Huzaifa-Rahim-Malik/Industrial-Fault-Simulator/docs/Sensor_Description.docx

S/N | Sensor Name | Signal Type | Number | Location of Sensors on System | Input Voltage @ Amp | Output Signal Range | Connector and Cable Requirement | DAQ | Remarks
1. | Accelerometer | Analog | 9 | 1. Gear. 2. Induction Motor. 3. Bearing x5. 4. On Table x2. | 18-30VDC @ 0.5mA to 8mA | 100mv/g | M12 Euro fast Connector Cable | Required
2. | Acoustic | | 7 | 1. Induction Motor. 2. Gear. 3. Bearing x5. | | | | Required
3. | Temperature sensor | Analog | 4 | 1. Induction Motor. 2. Gear. 3. Small Tank. 4. Large Tank. | 4 to 30V DC @1.5mA | 0 to 5 VDC | 3 pin Connector | Required
4. | Voltage Sensor | Analog | 2 | 1. Induction Motor. 2. Power Supply. | 24VDC @4-20mA | 0 to 1000V AC | Not Required | Required
5. | Current Sensor | Analog | 2 | 1. Induction Motor. 2. Power Supply. | 0 to 30A AC | 0 to 1V AC | 2 pin Terminal Block to female RCA Connector | Required
6. | Tachometer | Digital | 2 | 1. Before Gear. 2. After Gear. | 100-240V AC @ 10VA max | 30V DC @ 100mA | Not Required | Required
7. | Water Level Sensor (Float Switch Sensor) | Digital | 2 | 1. Small Tank. 4. Large Tank. | 220V DC@1.5A | 0 to 5V Digital Signal | Not Required | Required
8. | Flow Sensor | Digital | 2 | 1. Small Tank. 2. Large Tank. | 5V to 15V DC @ 15mA | 0 to 5V Digital Signal | 3 pin Male Connector | Required
9. | Humidity Sensor | Digital | 2 | 1. Small Tank. 2. Large Tank | 3.3V to 6V DC @ 1 to 1.5mA | 0 to 5V Digital Signal | 4 pin Connector

Industrial Test Rig Simulator Sensor Description
