Huzaifa-Rahim-Malik/Industrial-Fault-Simulator/docs/Labview_Implementation.pdf

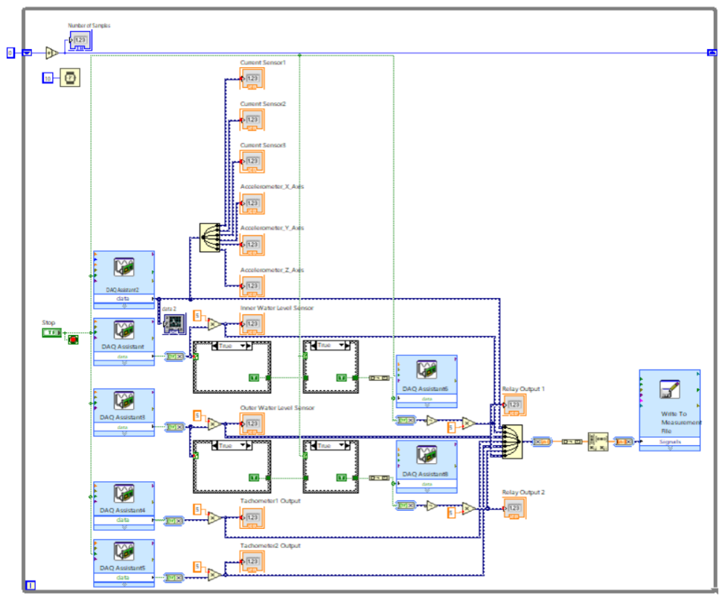
[picture p8: figure]
