Huzaifa-Rahim-Malik/Industrial-Fault-Simulator/Old_Design/docs/Hardware_Description.pdf

# DETAILED DESCRIPTION OF INDUSTRIAL TEST RIG

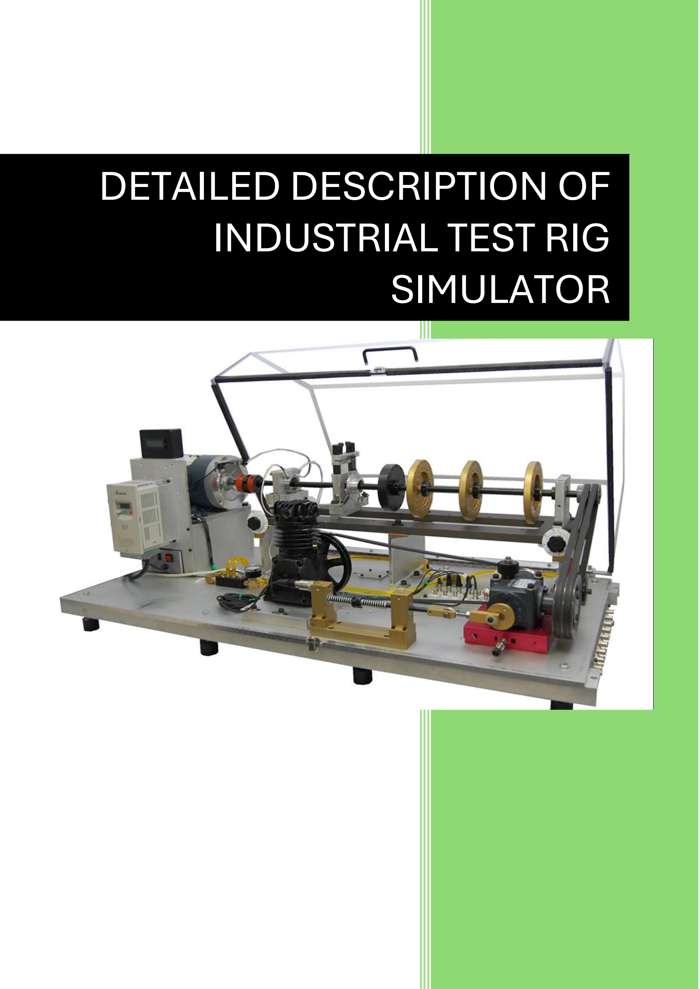
[picture p9: page 1]

# SIMULATOR

# Table of Contents

1. Introduction | 1
1.1) Overview | 1
1.2) Types of Sensors | 1
1.3) Other Technical Hardware used in System | 3
2. System Block Diagram | 5
3. Hardware Connection | 7
4. Software | 11
4.1) LabView Code | 11
5. Conclusion | 14

# List of Figures

Figure 1: Horizontal Water Level Sensor | 1
Figure 2: Vertical Water Level Sensor | 1
Figure 3: SCT-030 Current Sensor | 2
Figure 4: Temperature and Humidity Sensor | 2
Figure 5: Tachometer with Incremental Encoder | 2
Figure 6: Triaxial Accelerometer | 2
Figure 7: ATX Power Supply | 3
Figure 8: Induction Motor | 3
Figure 9: NI USB-6008 DAQ Device | 3
Figure 10:KTC Tension Controller with Powder Brake and Electromagnetic Clutch | 4
Figure 11: 2-Channel Relay Module with Magnetic Drive PumpError! | Bookmark | not
defined.
Figure 12:Industrial Test Rig Block Diagram | 6
Figure 13: Tachometer Pinout | 8
Figure 14: 2-Channel Relay Setup | 8
Figure 15: Industrial Test Rig Simulator Hardware Connection Schematic Diagram | 10
Figure 16: LabView Code | 12
Figure 17: Write to Measurement File VI | 13
Figure 18: LabView Front Panel | 14
Figure 19: Data Logged in text file | 14

# List of Tables

Table 1: Power Supplies Used in System | 3
Table 2: 3-Phase Motor Specification | 3
Table 3: Magnetic Pump Specification | 4
Table 4: Power Supplies Used by Devices | 7
Table 5: DAQ Device Connections | 11

## 1.Introduction

1.1) Overview
An industrial test rig simulator is basically a system that is designed to essentially replicate the functionality of real industrial machinery or equipment, thereby allowing actual situations to be tested, troubleshoot, and experimented without risking or costing real-world machinery. With the helps of sensors, we will be able to acquire the actual situation of the system/ equipment’s used in plants. This document includes the description about sensor used in this setup, their functionality in the system, operational information and hardware circuit implementation.
1.2) Types of Sensors
Different types of analog and Digital Sensors have been used in this industrial test rig simulator. The sensors that are used in this setup is given below:
- 1x Horizontal Water Level Sensor.
- 1x Vertical Water Level Sensor.
- 3x AC Current Sensor.
- 1x Temperature and Humidity Sensor.
- 2x Tachometers with Incremental Encoder.
- 3x 3-Dimensional Accelerometers.

The analog sensors such as AC current sensors and accelerometers gives an analogue output while the digital sensors such as horizontal water level, vertical level sensor, tachometer gives us digital output.

i. Horizontal Water Level Sensor
The horizontal water level sensor is used to identify water level in the system. They are installed at such systems where vertical space is not favourable. It is the passive sensor which only have two signals that is signal and ground. The sensor is installed in a water tank to measure water level of the tank and take necessary action according to the situations. The sensor is shown in figure 1.
ii. Vertical Water Level Sensor

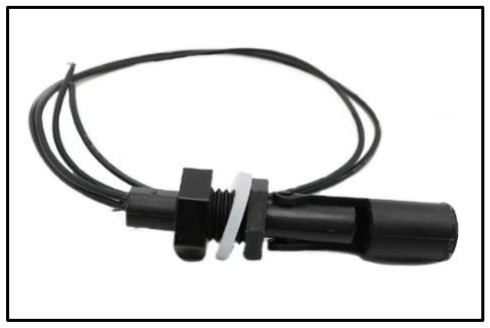
[picture p10: figure]

The vertical water level sensor is like horizontal water sensor as discussed above that is used to identify vertical water level in the system. It is the passive sensor which only have two signals that is signal and ground. The sensor is shown in figure 2.

Figure 1: Horizontal Water Level Sensor

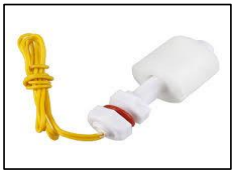
[picture p11: figure]

Figure 2: Vertical Water Level Sensor

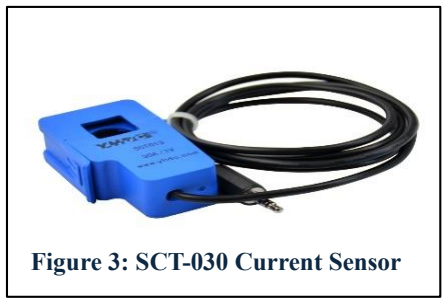
[picture p12: figure]
Figure 3: SCT-030 Current Sensor

iii. AC Current Sensor
The SCT-013-030 is a non-invasive AC Current Sensor Clamp Sensor 30A i.e. it is a current transformer that can be used to measure AC current up to 30 amperes. This SCT-013-030 Non-invasive AC Current Sensor 30A clamped around the supply line can measure a load up to 30 Amps and allow you to calculate how much current pass through it.

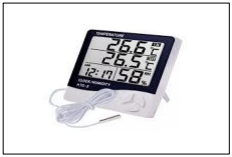
[picture p13: figure]

iv. Temperature and Humidity Sensor
Digital Thermometer and Hygrometer HTC-2 are 3 in 1 meter. This HTC 2 humidity meter allows you to display time clock, temperature, humidity and alarm function with a single cell. This digital meter has temperature range: -50 ~ 70 degrees (-58 ~ 158 ° F), large character LCD display, easy to read, lower power consumption This temperature and humidity meter can show temperature, humidity and time display simultaneously as shown in figure 4.
v. Tachometers with Incremental Encoder
CTA-4001A is a 3 in 1 device having timer / counter/ tachometer function with mixed timer and counter function. The 6-digit LCD display allow you to read this function with more accuracy and precisely. Different input like NPN/ PNP allow you to measure the function with different devices/sensors. The tachometer is
shown in figure 5. In this application of industrial test
rig, we use this device in tachometer with incremental
encoder (E6B2-CWZC) to measure the number of rotation (rpm) of 3-phase induction motor. The 2000 pulses per revolution substantially improve measuring accuracy. The encoder is NPN has an open collector output as shown in figure 5.

vi. Accelerometers

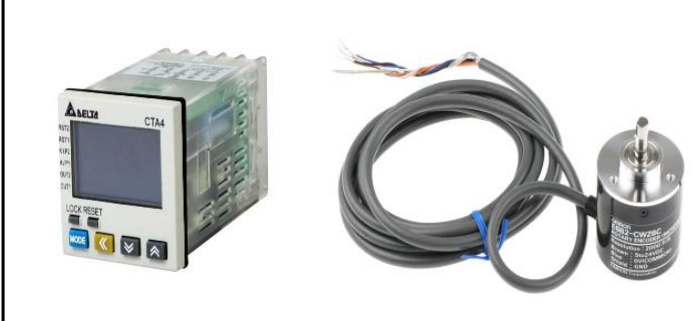
[picture p14: figure]

The CMCP760TT Side Exit Triaxial Accelerometer with Temperature output is the ideal accelerometer for most types of rotating equipment. The triaxial accelerometer allows us to measure each axis separately with a sensible accuracy of 100 mV/g. The CMCP760TT is waterproof and can be hosed down when using the proper extension cable. The sensor sensitivity 100 mV/g precisely measure the amount of vibration generates on the system with the help of extension cable such as CMCP605 series. The CMCP760tt is shown in figure 6.

Figure 4: Temperature and Humidity Sensor

Figure 5: Tachometer with Incremental Encoder

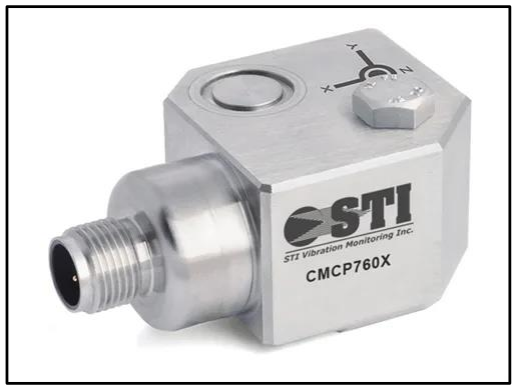
[picture p15: figure]

Figure 6: Triaxial Accelerometer

1.3) Other Technical Hardware used in System
Some other technical other than the sensors have been used in this system such as ATX power supply, 3-phase Induction motor, Data Acquistion Module, KTC power brake system with mechanical clutch, Relay module with magnetic drive pump, Current amplification circuit using BJT. The functionality of each hardware is discussed below:
i. ATX Power Supply
The ATX power supply is to power up the modules/ sensors used in the system. Total 6 supplies coming out from the supply that is mainly divide into two class i.e. Main supplies and Aux supplies. We are using only +12V and +5V supplies that is sufficient in our system while other supplies are of no use in the system. The ATX supplies used in the system for the respected sensor/module is shown in table 1. The ATX supply is shown in figure 7.

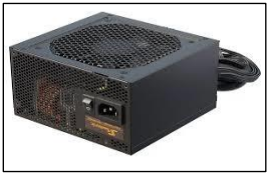
[picture p16: figure]

Power Supply | Used in
12V | Relay Module
5V | Tachometer, Incremental Encoder

Table 1: Power Supplies Used in System

ii. 3-Phase Induction Motor
A 3-phase induction motor is a device that does electromechanical energy conversion. It converts three-phase electrical power input into mechanical power output. The 3-phase AC is given at the input of the motor and the rotation of the motor in rpm is measured using incremental encoder and displayed rpm at the tachometer display LCD screen. The specification of motor is shown in table 2.

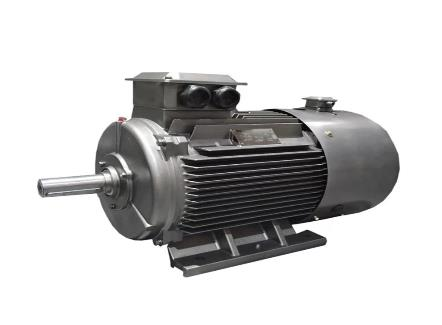
[picture p17: figure]

Parameter | Specification
Supply Voltage | 220V AC 3-Phase
Rating | 1.5hp
Rpm | 1450
Capacity | 1.1KW

Table 2: 3-Phase Motor Specification

iii. Data Acquistion Device
NI USB-6008 data acquisition device is used in this setup which is designed for basic data logging and measurements of sensor values. This DAQ device has 8-analog input channels and 16 digital channels with a sampling
rate of 10 KS/s. The analog sensors are connected
at an analog channel while the digital sensors are
connected at the digital channels of the DAQ. The DAQ device has a software support like LabView to view the measurement values and log these

Figure 7: ATX Power Supply

Figure 8: Induction Motor

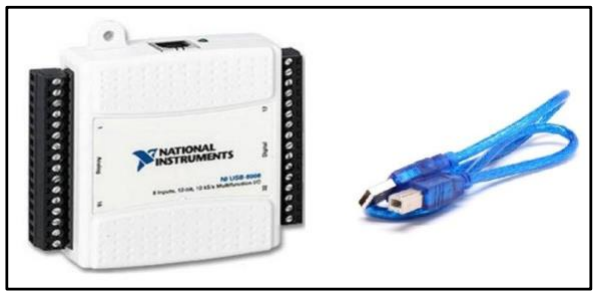
[picture p18: figure]

Figure 9: NI USB-6008 DAQ Device values in some file format like text or excel. The DAQ device is shown in figure 9.
iv. KTC Tension Controller with Powder Brake and Electromagnetic Clutch The KTC-812 tension controller is a device that is used to manage and control tension in various industrial and domestic applications with an option of adjustable torque, automatic tension calculation and over current protection. The powder brake is introduced in a system with a tension controller to apply a braking mechanism system when we want to increase load/tension on the system. Similarly, electromagnetic clutch is used to engage or disengage the shaft which is connected with the powder brake. When it is connected with brake shaft it acts as a tension/load which is applied to the system.

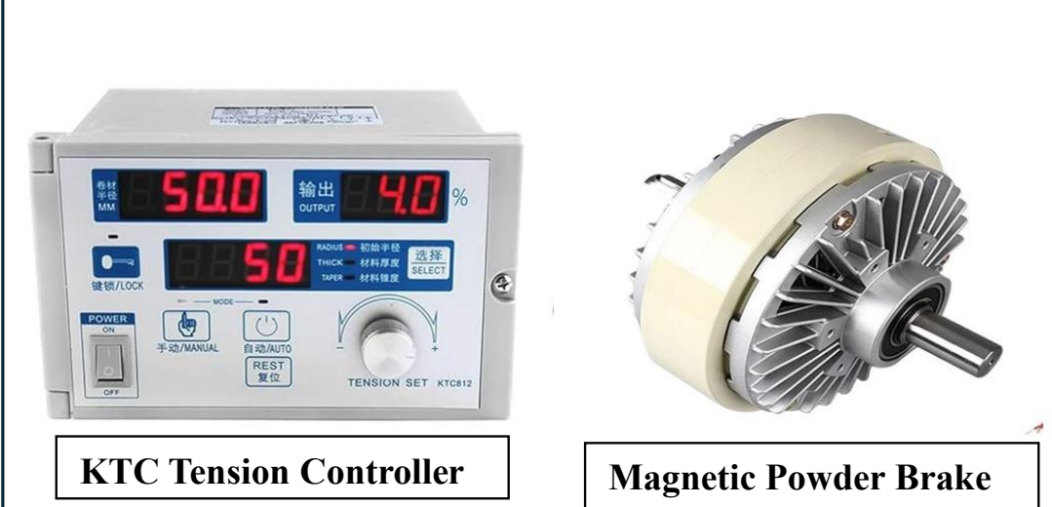
[picture p19: figure]

v. 2-Channel Relay Module with Magnetic Drive Pumps

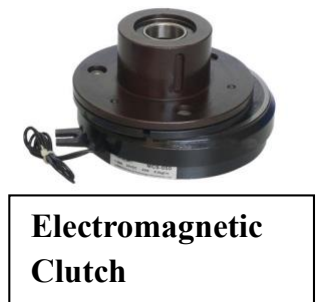
[picture p20: figure]
Electromagnetic; Clutch

A 2-channel relay module is a device that allows you to control two separate circuits with a single module. The relay channel is used to drive the magnetic drive pumps. The input of the relay channel is dependent on the value of water level sensor as described above. If the sensor detects decrease in the water level in tank, the pump starts and maintain the water level of the tank. As, relay module works on active low signal so whenever it detects a low level at its input, it will turn on the pump. The specification of the drive pump is shown in table 3, and both the relay and pump are shown in figure 11.
Parameter (Magnetic Drive) | Specification

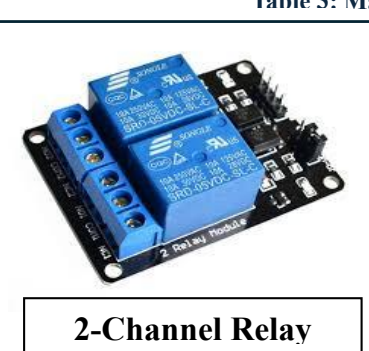
[picture p21: figure]
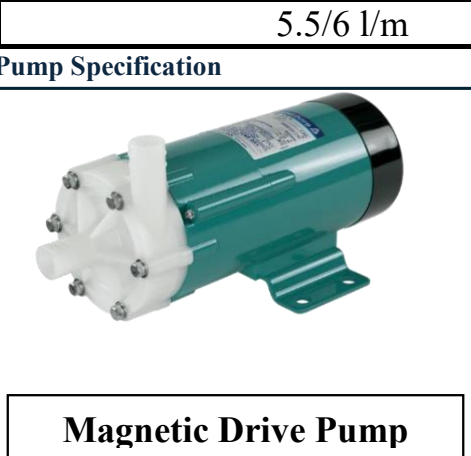
[picture p22: figure]

Supply Voltage | 220V AC
Current Rating | 0.08A
Frequency | 50Hz
No of Poles | 2
Max Capacity | 5.5/6 l/m

Table 3: Magnetic Pump Specification

Figure 10:KTC Tension Controller with Powder Brake and Electromagnetic Clutch

KTC Tension Controller | Magnetic Powder Brake
2-Channel Relay | Magnetic Drive Pump

vi. Current Amplification Circuit Using BJT
As the switching of relays are totally dependent on the measurement of water level sensors. The maximum current output of USB-6008 is 8mA approximately while the current required by the relay module is minimum 30mA. So, a circuit is designed using BJT to provide adequate amount of current to relay module. For this purpose, NPN transistor is used in switching configuration. As, the DAQ device digital lines are internally pull up. For this purpose, we used a NOT gate at the specific output lines which is connected with the BJT so that the relays do not on when the DAQ device is powered on and unless the LabView is code run on the PC.

## 2.System Block Diagram

The Industrial Test Rig replicates the behaviour of industrial equipment’s at a smaller level without damaging the actual equipment which is being used in complex plants. This will save us in many aspects like cost-effective solution, time saving and do not disturb the working condition or environment in which the system is working. The sensors/devices which want to implement on plant in future will be implemented on the system which is smaller in form factor than the actual system, but the functionality of both systems is the same. For this a small setup in designed and developed on which multiples analog and digital sensors have been installed on the system. In this system, it will actually monitor the status of the sensor and determine the remaining useful life of the equipment’s. Many sensors like accelerometer, accelerometers, tachometers etc will be used to measure sensor reading, displays the real-time behaviour of the system and predicts if any of the fault occur or will occur nearby in the system.

First of all, A three phase induction motor is used in the system having a capacity of 1.5hp is installed in a system to actually give a rotary moment in the system on which multiple mechanical and electrical equipment’s are attached. The actual rpm of motor is approx. 1500rpm. The motor is connected to bearing, flywheel and worm gear through a mechanical shaft as shown in figure 12. When the motor shaft rotates, it also rotates all these mechanical equipment attached to it as well. To accurately measure the rpm of motor, tachometer sensor with incremental encoder is attached using a pulley-based system. The pully is connected to mechanical shaft and incremental encoder and displays the rpm on tachometer LCD. If rpm decreased than the minimum threshold value, the output of tachometer will be changed and observed on real-visualization screen. When the motor’s rpm pass through the gear worm, it will actually reduce the rpm to 1:7 and the rpm after gear worm will approx. 185. So, again to measure rpm after gear, a similar setup is installed and measure rpm after worm gear. For the accurate current measurement, a non-invasive current sensor as discussed above is installed on the three phase AC lines of the induction motor to continuously measure the current consumption of the motor. Accelerometers are also introduced in the system to measure and monitor the vibrational effect of the system. Three accelerometers are used for this purpose and for each single axis (X, Y and Z), each accelerometer gives vibration of single axis being used. Two water level are installed in a water tank to monitor the level of fluid(water) present in tank. If the water level decrease due to any sudden change like attack on sensor reading or sensor data manipulation so that the sensor detects any changes, it will give signal to DAQ and DAQ will give output signal to 2-channel module which turn on the magnetic motor pump

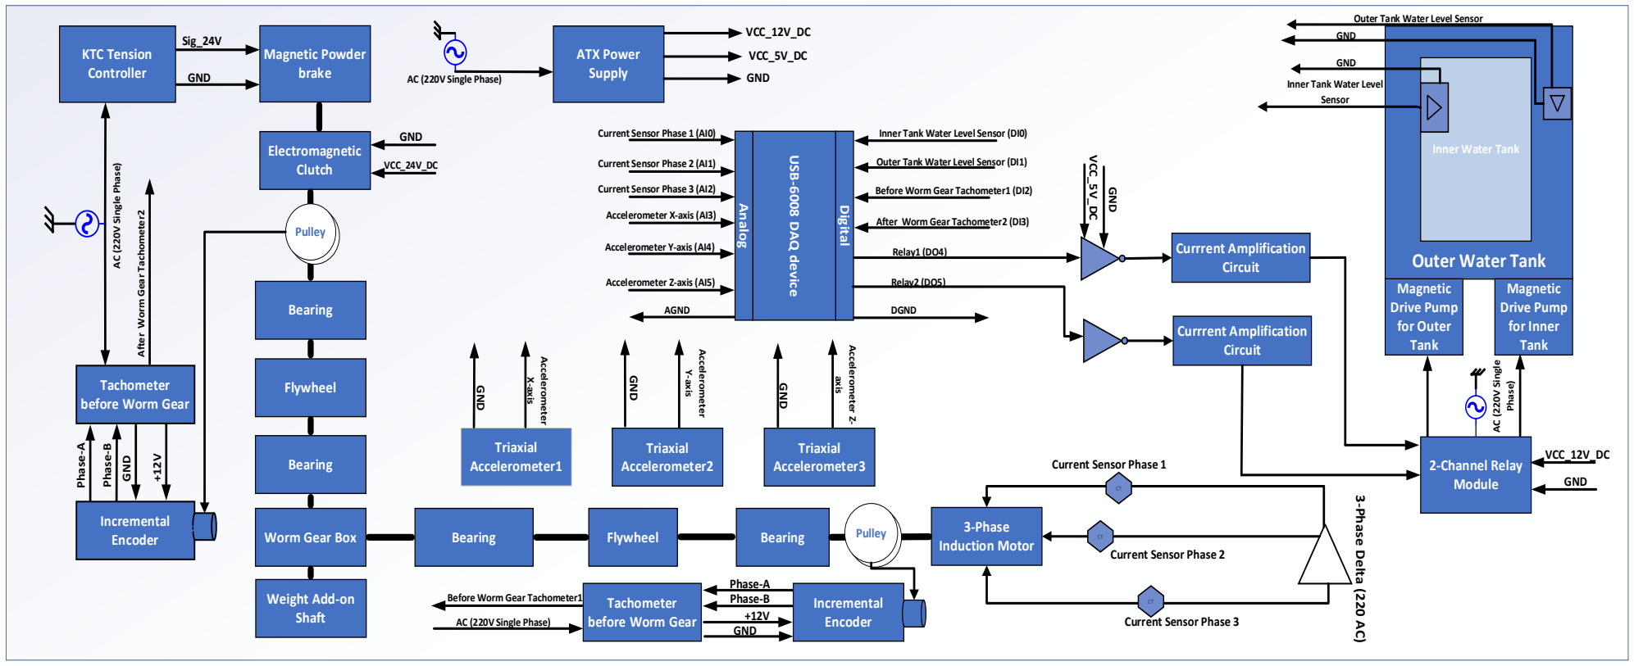
[picture p23: figure]
Magnetic Powder brake; Electromagnetic Clutch; KTC Tension Controller; Flywheel; Worm Gear Box; Sig_24V; Bearing; 3-Phase Induction Motor; 3-Phase Delta (220 AC); ATX Power; Supply AC (220V Single Phase); VCC_12V_DC; Inner Tank Water Level Sensor (DI0); Outer Tank Water Level Sensor (DI1); Before Worm Gear Tachometer1 (DI2); After Worm Gear Tachometer2 (DI3); Relay1 (DO4); Relay2 (DO5); DGND; Current Sensor Phase 1 (AI0); Current Sensor Phase 2 (AI1); Current Sensor Phase 3 (AI2); Accelerometer X-axis (AI3); Accelerometer Y-axis (AI4); Accelerometer Z-axis (AI5); AGND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

Page 6 of 14

Figure 11:Industrial Test Rig Block Diagram

which will maintain the level. This feature is added in the system to verify if any cyber attack performed on the system. So, the system detects it and inform the concerned person so that any misuse of classified data can be used by some unknown person. To turn on relay a current amplification is used as discussed above to accurately turn on or off the relay module. All the sensors value are monitored through a data acquisition device of National Instrument NI-USB6008, and these values are stored in text file to utilize by end-user and this file is utilized for real-time data visualization of sensors. A weight on mechanism using shaft is used to introduce the load effect on the induction motor. When load increase, the rpm of motor reduces and vice versa helps us to give estimated rpm on a specified load applied to system.

VCC_5V_DC USB-6008 DAQ device Analog | Digital
Accelerometer3 GND | Accelerometer Z- axis | AC ⁽220V Single Phase⁾ Accelerometer X-axis AC ⁽220V Single Phase⁾

## 3.Hardware Connection

As different types of sensors (analog and digital sensors) are used in this industrial test rig setup on which some of the sensors are passive sensors like water level sensor, some of them uses only digital supplies like relay, electromagnetic clutch while some of them use both AC and DC supplies both like tachometers. Current sensors are non-invasive category type sensors that work on the principle of electromagnetic induction is another type of passive sensor having built-in resistor in it that we will give output in the form of voltage. Accelerometers are current source sensors that need constant current source (4-10mA) for proper functionality. The table 4 describes the basic supply (AC or DC) that is used by the sensors or technical hardware used in industrial test rig setup.

Device | Power Supply | Voltage | Output
AC Induction Motor | AC | 220V (Three Phase) | Nil
Tachometer | 1. AC 2. DC | 1. 220V (Single Phase) 2. 5V | Digital
Incremental Encoder | DC | 12V | Digital
2-Channel Relay Module | DC | 12V | AC
Electromagnetic Drive Water Pump | AC | 220V (Single Phase) | Nil
24V DC Adapter | AC | 220V (Single Phase) | 24V DC
Electromagnetic Clutch | DC | 24V | Nil
KTC-812 Controller | AC | 220V (Single Phase) | DC (0-24V)
Powder Brake | DC | 0 to 24V | Nil
ATX Power Supply | AC | 220V (Single Phase) | 5V DC 12V DC
Water Level Sensor | Passive | Nil | Digital
Current Sensor | Passive | Nil | Analog
Accelerometers | Constant Current Source | 4-10mA | Analog

Table 4: Power Supplies Used by Devices
i. 3-Phase Induction Motor
So, first of all you need a 3-phase AC supply in order to start the induction motor to start the rotary movement in the system. The motor is connected in 3-phase delta configuration. By using delta configuration, it will provide higher power and torque to motor. When the motor starts it will rotate the shaft with its maximum rpm when no load is applied at motor.
ii. Tachometer With Incremental Encoder
For rpm measurement, a tachometer which need 220V single phase is required at pin 4 and 5 of the tachometer. The pinout configuration of tachometer is shown in figure 13. The tachometer is operated in tachometer configuration. For accurate setting, please refer to tachometer datasheet/ manual. As, tachometer OUT1 is open collector. So, we need a pull-up resistor at its output to correctly operate the built-in transistor and record the data on DAQ device accurately. For that, 4.7KΩ resistor is pull with 5V DC of ATX power supply.

Tachometer is used with incremental encoder, which measures the number of rotation and gives a signal if rotations of motor are out of set threshold. The incremental encoder needs supply voltage between 5-24V so for that we provide dc supply 12V which is available on pin#11 of tachometer. So, the output of incremental encoder (Phase A, Phase B) is given at tachometer pin #12,13. The pin#14 of tachometer is
connected with pull-up resistor as well as the Digital pin
(P0.2) of DAQ while the pin#9 and 11 are connected

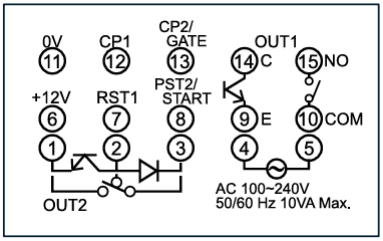
[picture p24: figure]

with the ground pin of ATX supply. As, two tachometers are used. Same setup is used for other tachometer as well as incremental encoder, but the output of tachometer is connected at the Digital pin (P0.3) of DAQ.

iii. 2-Channel Relay Module
The 2-channel Relay Module operates on a 12V DC supply which is provided through ATX power supply. As, the relay works on active low signal so it will turn on the relays when the input signal is low. To effectively switching the relays, the relays need minimum current of 30-40mA, but the current provide by the DAQ pins is approximately 8mA. For accurate current amplification, a transistor is used for current amplification in common emitter configuration as a switch. As, relay are worked on active low while NPN transistor goes in active region when signal is high on its base. The output (collector) is connected to digital input pin of the relay module. As, the DAQ digital pins are internally pull-up. So, when the DAQ is powered on, it will give high signal at the base and turn on the relay load. For that purpose, an inverter gate (SN7404hcn) is used between the DAQ pin and transistor base so that when the DAQ is connected with PC it will not turn on the load automatically unless the code is run on the DAQ. As, it is two channel relays, so two setups of transistor are used. Both the input that is connected to inverter gate is coming out from DAQ digital pin (P0.4 and P0.5 respectively). The block diagram is of this setup is show in figure 14.

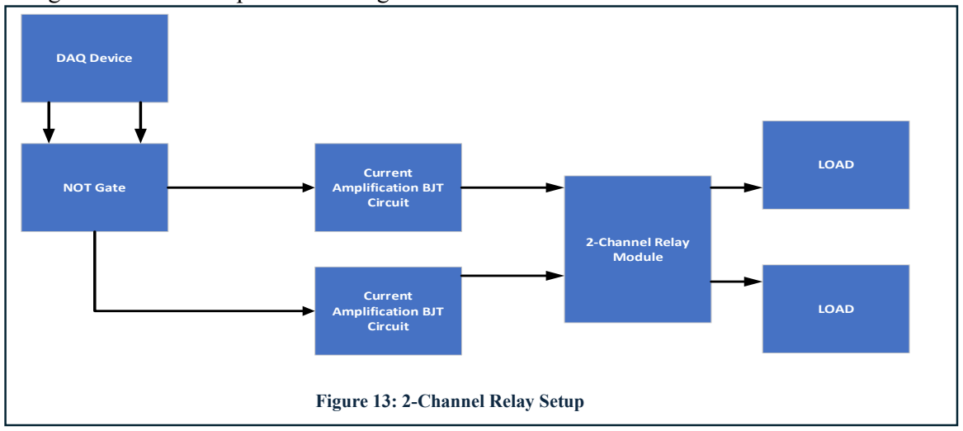
[picture p25: figure]
Figure 13: 2-Channel Relay Setup; NOT Gate; Current Amplification BJT Circuit; 2-Channel Relay Module; LOAD; DAQ Device

iv. Electromagnetic Water Pumps
The Electromagnetic pumps are connected to Relay module. The relay module will turn on or off the pump depending on the signal based on the input of relay module. The pump will

Figure 12: Tachometer Pinout work on AC (220V single phase). The main line is connected with AC supply while the neutral line of motor is connected to NO and COM points of the relay. This will act as a switch between this point for controlling the electromagnetic pumps.
v. Electromagnetic Clutch
Electromagnetic Clutch is used to connect to two shafts of the system. This will provide a continuous rotary movement to two disconnected shafts. As, magnet is present in the clutch, when current passes through the magnetic, it will generate magnetic field around it and helps to connect the shaft. This electromagnetic clutch will work on 24V DC voltage, which is provide through a 24V,0.75A DC adapter.
vi. KTC-812 Controller with Powder Brake
KTC-812 is an automatic/manual tension controller which is used to provide tension on some system. This tension controller needs a 220V AC at its input for power and creates a DC signal up-to 24V depending upon tension created by the controller manually using a knob on the controller or automatically by using a hall effect sensor. The powder brake is introduced in the system with tension controller to introduce the effect of load on the system which helps in visualizing the motor current capacity as well as rpm measurement when the load increases. The powder brake contains two signals i.e. signal and ground that are connected at the output of tension controller signal named as 24V and GND. The tension on the system is adjusted manually right now. Powder brake also contains a magnet in it so that if the current/voltage increase, more magnetic field will be generated, and more load is applied at the system.
vii. ATX Power Supply
ATX power supply is used in the system to provide a DC voltages which is used by the system sensors. The power supply operates on 220V AC and generates six DC voltages at the output. We only use two supplies (+5V and +12V) out of six supplies. The PS-ON pin on the ATX connector is connected with ground pin to work the supply in idle mode.
viii. Water Level Sensor
Two water level sensors i.e. Horizontal and Vertical are used in the system. Both of these sensors are passive sensors that does not any supply to operate. So, these sensors are connected at DAQ digital pins. These sensors are connected at the digital pin (P0.0 and P0.1) of DAQ device respectively.
ix. Current Sensor
This current sensor is non-invasive type AC sensor that means we do not need to connect it in series with the AC supply line. We have connected on power line like clamp meter, and it will measure the current. The current sensor is an analog sensor, and it will connect at pin#AI0, AI1, AI4 of the analog pins of DAQ device.
x. Accelerometer Sensor
The accelerometers used in this setup works on a 2-line setup works system on which the signal acts on a power line as well as signal line on a same line. As, this sensor needs a constant current source. The three accelerometers are used separately for each axis and the signals are connected gives analog signal at the output. So, these signals are connected at the analog pins# AI5, AI2 and AI6 respectively.
The complete schematic diagram is shown in figure 15 which shows us all the device’s connections of the setup.

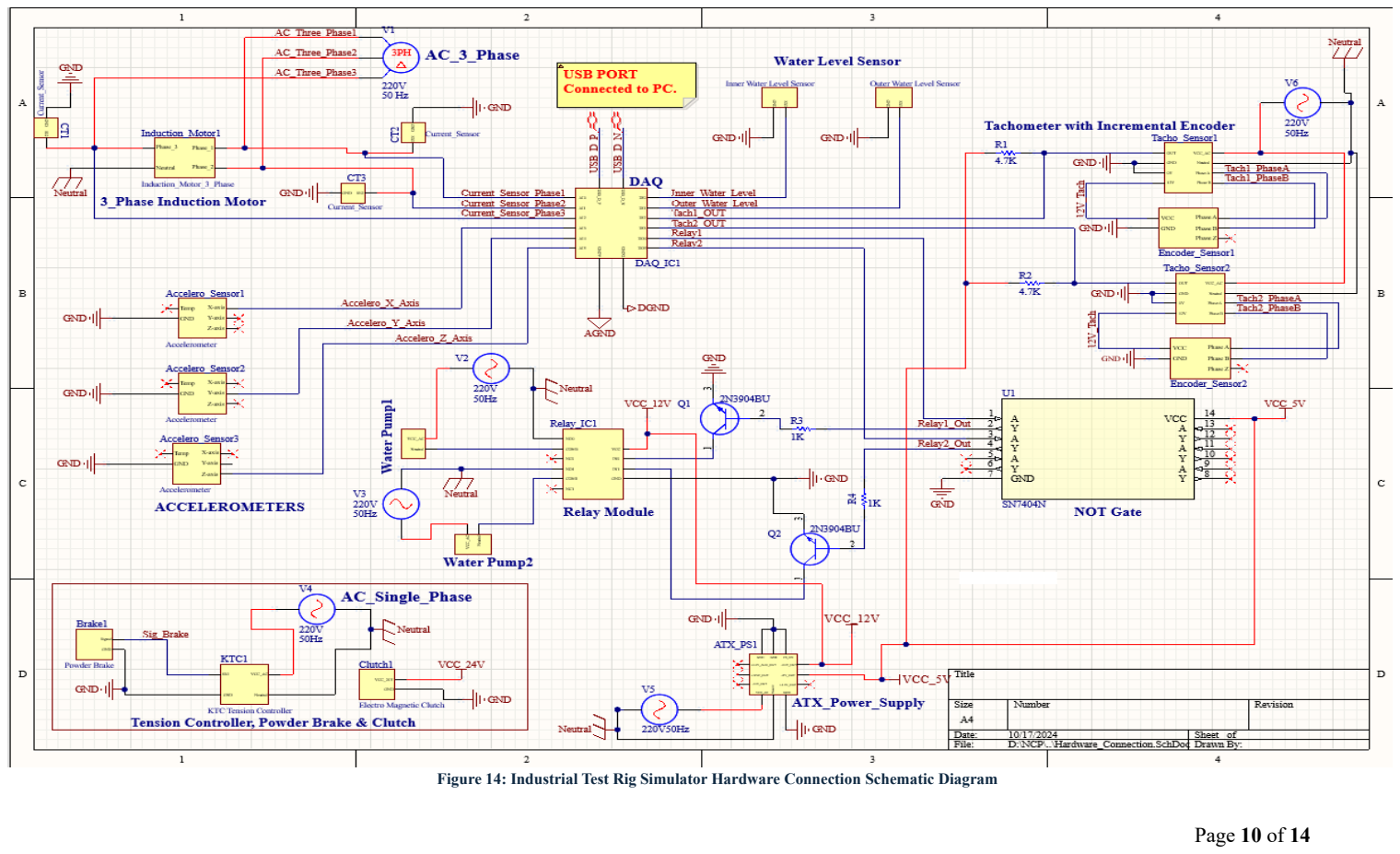
[picture p26: page 12]

Page 10 of 14

Figure 14: Industrial Test Rig Simulator Hardware Connection Schematic Diagram

xi. USB-6008 DAQ Device
As the DAQ devices is powered up using USB. The device is connected to PC and program is loaded through LabView into the device. The connection which are connected to DAQ is shown in table 5.
DAQ Connected to | DAQ Pin# | PIN Name
Current Sensor | 2,3,5 | AI0, AI4, AI1
Accelerometers | 6,8,9 | AI5, AI2, AI6
Horizontal Water Level | 17 | P0.0
Vertical Water Level | 18 | P0.1
Tachometer1 | 19 | P0.2
Tachometer2 | 20 | P0.3
Relay1 input | 21 | P0.4
Relay2 input | 22 | P0.5

Table 5: DAQ Device Connections

## 4.Software

The DAQ device is manufactured by the National Instruments (NI) which only works and programmed with its compatible software. For this purpose, LabView 2024 Q1 32-bit Community edition is used, and code is developed for this setup using this software. As, LabView offers you graphical programming as compared to other programming languages. By using VI’s, you have created logic and program your device. Some of built-in VI’s for DAQ device is available in LabView that are used for data logging. We can use that VI’s that will log the values of the sensors and stored these values in a file like text/excel.

## 4.1) LabView Code

LabView code will help us to understand the functionality of DAQ device. The DAQ device has an ability to operate as an input or output depending on the functionality of pin describe in DAQ Assistant. DAQ Assistant is a built-in VI available in the software which is used with the DAQ devices and helps us to get data without utilizing any other VI. We have to enable the pin in assistant at which the sensor/device is attached to pin. If you are using analog sensor on USB-6008, then there is option of taking continuous samples to read for multiple sensors at a single instance but if you are using digital sensor on this DAQ, there is no such option of continuous sampling. For digital sensor, you have to sample one time on demand. Also, for digital sensor you have to use more DAQ Assistant VI’s if you are using multiple digital sensors that is not required in analog sensors as shown in figure 16. All the analog sensor measurement values are get using one DAQ Assistant VI while getting the digital sensor data, we have to separate VI for each sensor. The data is updated after every 10ms in the DAQ device and with the help of shift it will also count the number of samples we gathered. Both the sections analog and digital are discussed separately.

i. Analog Section
The analog section gets the data of the analog sensor. Six analogs sensors are used in this setup. When enabling the pins in DAQ setting, all the sensors will act as an input. We will get the data of all these sensors. Now, after getting the data, it will come from one pin (data out) of DAQ Assistant. We have monitored the data of each sensor separately. For this purpose, we use split VI available in the LabView to separate these signals and monitor them. Every signal is shown separately using indicator VI.

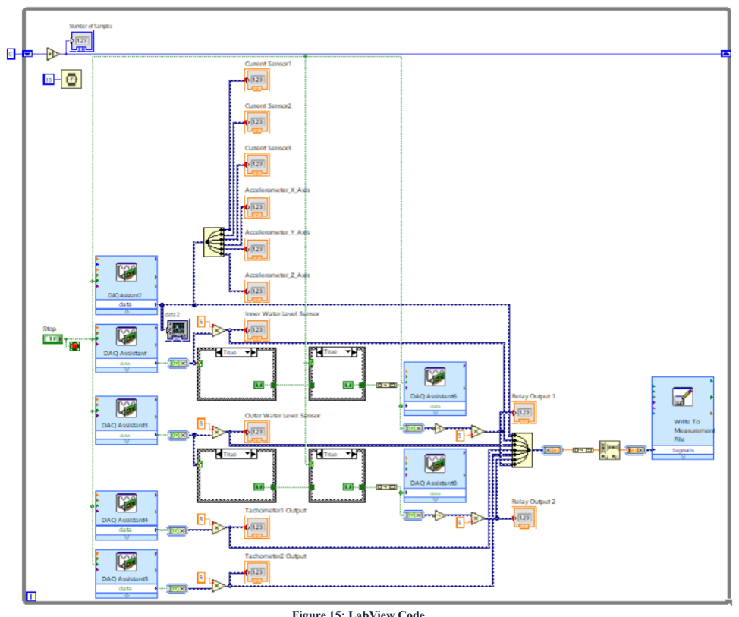
[picture p27: figure]

ii. Digital Section
The digital section gets the data of the digital sensors. When enabling the pins in DAQ setting, four digital pins (P0.0-P0.3) will configure as an input pin while P0.4 and P0.5 will configure as an output pin. Devices like tachometers, water level will act as input sensor while the signals which drives the relay module will act as output signal. All the pins of digital sensor used by DAQ are configured in separate VI’s. The DAQ Assistant and DAQ Assistant3 will be used to get the water level sensor reading. Similarly, the DAQ Assistant4 and DAQ Assistant5 will be used to get the tachometer reading and DAQ Assistant6 and DAQ Assistan8 will be used to generate the signal for the relay depending upon the signal of the water level sensor. As, data is in binary form when it is out from the DAQ Assistant. So, we have to convert this data into some scalar number for a human understandable form. For this, we have to covert

Figure 15: LabView Code this data into scalar array using a VI named as covert to dynamic data type and then multiply this scalar quantity with a constant ‘5’. So, when digital signal is low, it is represented by ‘0’ and when signal is high, it is represented by ‘5’.
The water level sensors as well as tachometer have a simple code in which DAQ assistant VI will get the data and store it in a file, but a logic is implemented for the signals that drive the relay module. As, these signals mainly depend on the signal of the water level sensors present in the tank. So, a conditional statement is used for that purpose, in which a condition is true, it will generate a high signal and when the condition is false, it will generate a low signal at that pin of DAQ device. Same condition is applied for both the sensors. As, horizontal sensor when close, it will generate a low signal at it signal pin while for vertical sensor when close, it will generate a high signal at it signal pin. For that purpose, we have an option in DAQ assistant to invert line, which will invert the signal that is coming to DAQ device. So, horizontal sensor signal is inverted in setting configuration to make the condition favourable while vertical sensor remains the same. Another conditional statement is used after the previous conditional statement, that will reset the status of these specific DAQ pins to zero when a stopped condition arrived or programmed is stopped.
iii. Data Logging
When both the analog and digital sensor is acquired by using DAQ assistant VI’s. We have to log this data in some file to view or visualize the status of sensors real-time. LabView have an advantage of logging data in text file or excel file. We are logging data in a text file (. lvm extension). So, for logging data we have a used a merge signal VI that will merge all signals into one signal. After merging all the signals, we used a VI that will change the data into dynamic type of array as some of data is floating and some of data is in discrete form. This VI change to dynamic data will create an output of array of floating numbers. As, output data is in array form, so we have to make a 1-D array. For that purpose, build array VI is used with a transpose matrix VI that will take the transpose the array matrix of (1xn). Build array will store the values in a single column, that why we use transpose function to specify 1 sample of all sensors in single row and each column
represent specific sensor value at that
sample. The last step in data logging in
writing this data into some file. This can be done by using VI named as “Write to Measurement File VI”. This VI is
configured | according | to | user
requirement as shown in figure 17 and when you specify the path of log file. The file is updated after every amount of interval as you specified in your code (for our case, value is updated after every 10ms). The indicator placed on the code
will be placed on the front panel of the
LabView to visualize the sensor reading

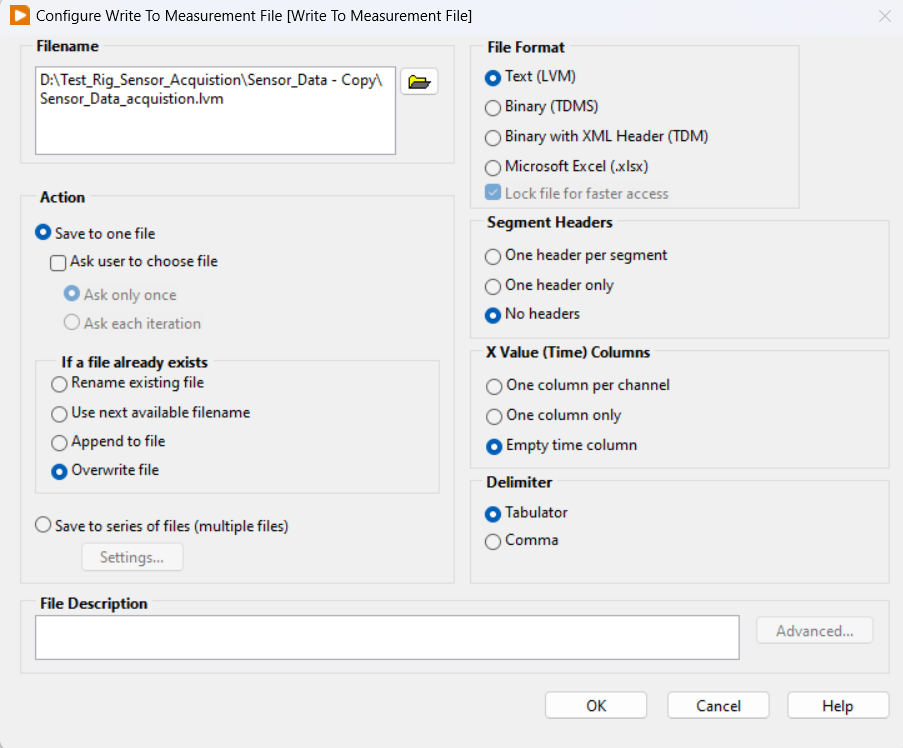
[picture p28: figure]

as shown in figure 18. | Figure 16: Write to Measurement File VI

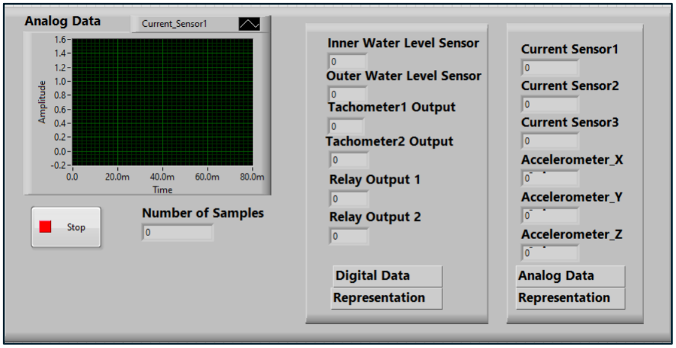
[picture p29: figure]

When the data is saved in text file and after acquiring all the data. When you open the file, it will open in the following format as shown in figure 19.


## 5.Conclusion

The document presents preliminary technical specifications as well as the detailed description of both hardware and software technicalities for the industrial test rig simulator setup. The industrial test rig simulator containing 12 sensors (6x analogs and 6x digital sensor) having been used in this setup and acquire data of these sensors using NI DAQ device (USB-6008) and store this data in some text file to utilize further for future application like predicting the remaining life of equipment’s, determine the behaviour of some equipment in the setup. This will save us in many aspects like saving the complex system from critical damage, cost-effective solutions, and implementing a new scenario to system before applying on actual system. This will also help us in maintenance of the complex plants where hundred of sensors are used at a time.

Figure 17: LabView Front

Figure 18: Data Logged in text file
