Huzaifa-Rahim-Malik/Industrial-Fault-Simulator/images/ATX.jpg

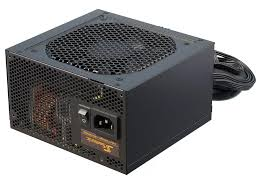
images/ATX.jpg
