Huzaifa-Rahim-Malik/Industrial-Fault-Simulator/images/clutch.jpeg

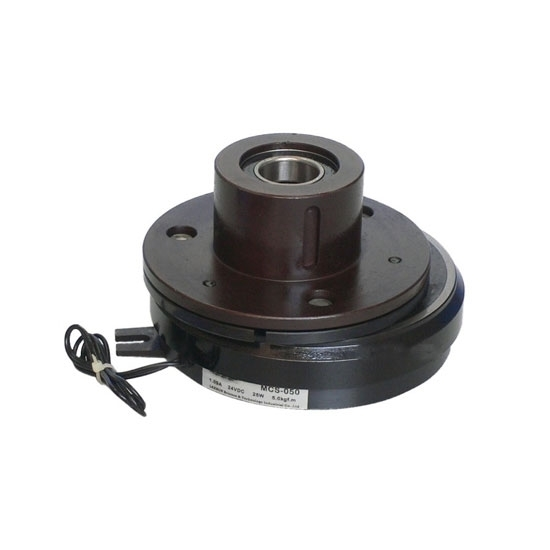
images/clutch.jpeg
