Huzaifa-Rahim-Malik/Industrial-Fault-Simulator/images/DAQ.png

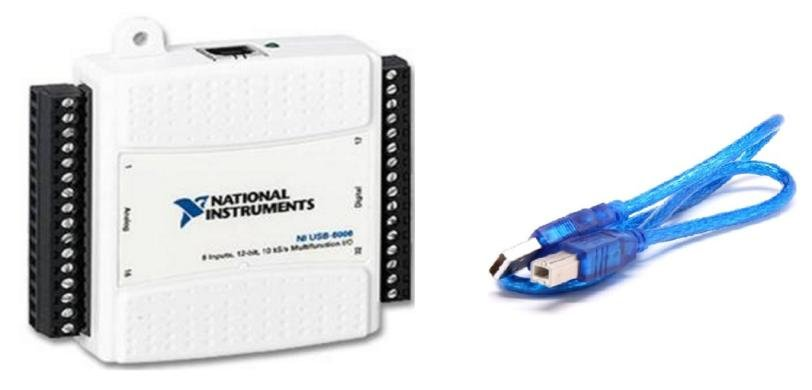
images/DAQ.png
