Huzaifa-Rahim-Malik/Industrial-Fault-Simulator/images/GUI.jpeg

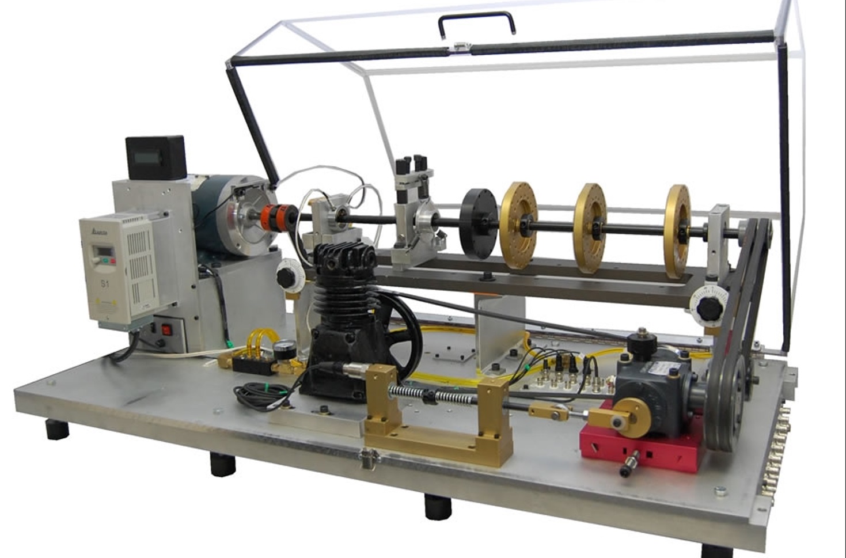
images/GUI.jpeg
