Huzaifa-Rahim-Malik/Industrial-Fault-Simulator/images/Horizontal Sensor.png

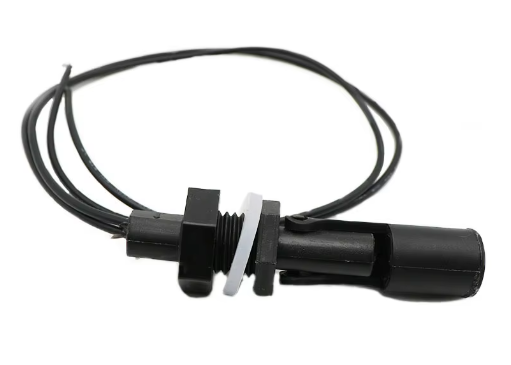
images/Horizontal Sensor.png
