Huzaifa-Rahim-Malik/Industrial-Fault-Simulator/images/KTC.jpg

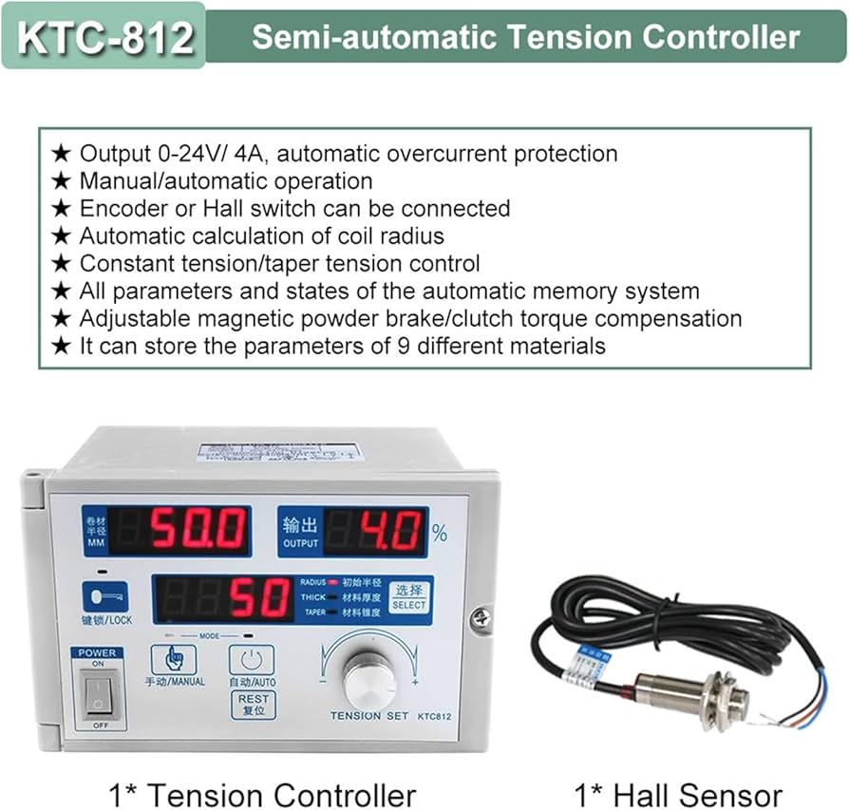
images/KTC.jpg
