Huzaifa-Rahim-Malik/Industrial-Fault-Simulator/images/powder brake.jpg

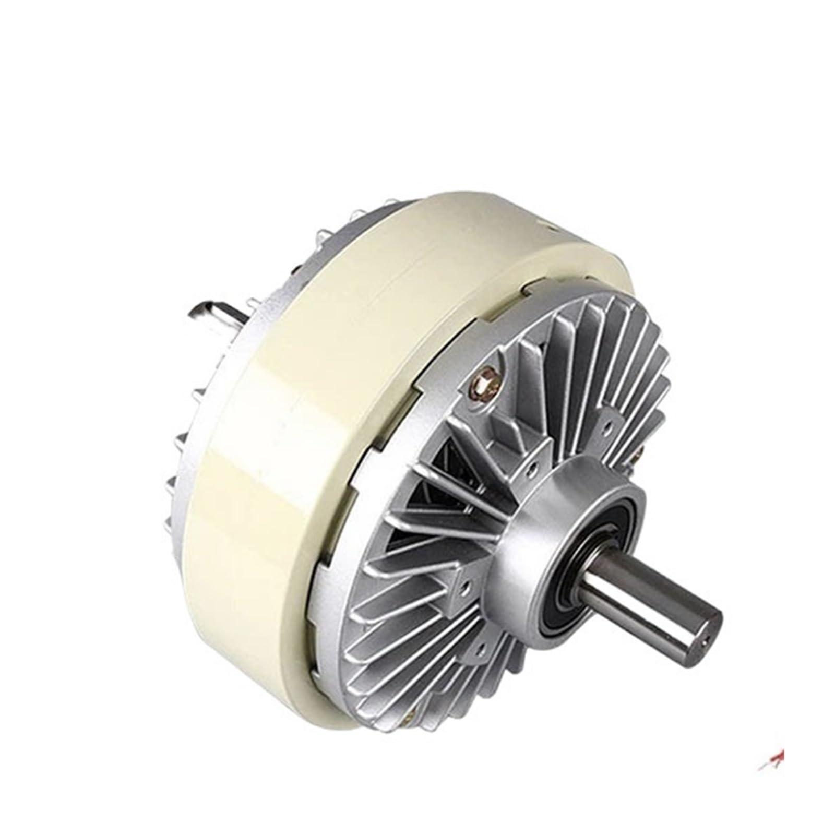
images/powder brake.jpg
