Huzaifa-Rahim-Malik/Industrial-Fault-Simulator/images/Temp.jpg

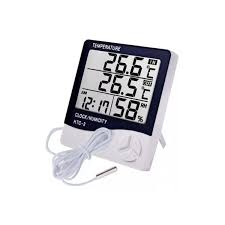
images/Temp.jpg
