Huzaifa-Rahim-Malik/Industrial-Fault-Simulator/docs/Test_Rig_Parts.xlsx

Sheet: Sheet1
1 | Induction Motor
2 | Data Acquistion Device | iQAD-934
3 | Frequency Counter Module | ADAM-4080-_E
4 | USB to Serial Convertor | ULI-351T
5 | USB 3.0 Hub | BB-USH207
6 | Variable Frequency Drive | VFD007M21A
7 | Incremental Rotary Encoder | E6B2-CWZC
8 | Electromagnetic Drain | A20-S15-S2-C
9 | Brake Tension Controller | KTC-812
10 | Eurostyle Cable Assemblies | CMCO605M
11 | Electromagnetic Clutch | ATO-MCS-1-006
12 | Circuit Breaker
13 | Relay Switch Driver
14 | BNC to BNC Coaxial Cable
15 | BNC Connectr Patch
16 | Serial Port Cable | RS232-DB9
17 | Mini Tachometer | CTA-4001
18 | Water Proof Temperature Sensor | LM35
19 | Liquid Water Level Sensor
20 | Current Profile Sensor | SCT-013-030
21 | Voltage Sensor | JDA4U
22 | Flow Sensor | YF-B1
23 | High Temperature Sensor Wire
24 | Crimp Connector

Sheet: Sheet2
Sensor Name | Part Number | Initial Required Quantity | In LAB
Vibrometer | CMCP760TT | 9 | 5
Acoustic
Water Level Sensor | https://www.evselectro.com/liquid-pp-side-mount-horizontal-water-level-sensor-float-switch-for-pool-tank-6887 | 2 | 1
Flow Sensor |  | 2 | 2
Voltage Sensor |  | 2 | 1
Current Sensor | SCT-013-030 | 2 | 3
Tachometer | CTA-4001 | 2 | 2
Temperature sensor | LM35 | 4 | 5 |  | HTC-2
Humidity Sensor | DHT-22 | 2 | 2 |  | HTC-2
Incremental Encoder | E6-B2-CWZ6C | - | - |  | NI-USB 6008
 |  |  |  | And GATE | SN7404hcn
 |  |  |  | BJT Setup | 2n3904
