Huzaifa-Rahim-Malik/Industrial-Fault-Simulator/New Design/Test Rig Design Sensor Description.xlsx

Industrial Test Rig Simulator
Supply | S/n | Component | Voltage Supply Requirement |  |  | Data Acquistion Requirement |  |  | Required any Part
 |  |  | Voltage | AC/DC | Output | No of Signals | DAQ Pin | Output Part
AC Supply 3 Phase | 1 | Induction Motor | 220V | AC 3- Phase | N/A | 3 | N/A | N/A | N/A
 | 2 | VFD | 220V | AC 3- Phase | 3-Phase Supply | 3 | N/A | N/A | Din Rail
 | 3 | EMC/EMI Line Filter | 220V | AC 3- Phase | 3-Phase Supply | 3 | N/A | N/A | Din Rail
 | 4 | 3 Pole Miniature Circuit Breaker | 220V | AC 3- Phase | AC 3-Phase | 3 | N/A | N/A | Din Rail
AC Supply 1Phase | 5 | 2 Pole Miniature Circuit Breaker | 220V | AC 1-Phase | AC 1-Phase | Not Required |  |  | Din Rail
 | 6 | HDR-60-12 | 220V | AC 1-Phase | 12V DC | 2 | N/A | N/A | Din Rail
 | 7 | HDR-60-24 | 220V | AC 1-Phase | 24V DC | 2 | N/A | N/A | Din Rail
 | 8 | Tachometer | 220V | AC 1-Phase | Display | 2 | N/A | N/A | Mounting Bracket
 | 9 | Stainless Steel Solenoid Valve Pump | 220V | AC 1-Phase | Water | 2 | N/A | N/A | N/A
DC 24V Supply | 10 | AC Current Sensor (Single Phase) | 24V | DC | 4-20mA | Not Required |  |  | Din Rail
 | 11 | AC Current Sensor (Three Phase) | 24V | DC | 4-20mA | 3 | A0,A1,A2 | Open Wires | Din Rail
 | 12 | 3 Phase AC Voltage Transducer | 24V | DC | 4-20mA | 3 | A3,A4,A5 | Open Wires | Din Rail
 | 13 | Isolated DC Voltage Sensor | 24V | DC | 4-20mA | Not Required |  |  | Din Rail
 | 14 | Electro-Mechnanical Clutch and Brake | 24V | DC | Mechnical | Not Required |  |  | N/A
 | 15 | HS-551 Vibration Module | 24V | DC | Constant Current Source 2-10mA for CMCP786A | 4 | A6,A7,A8,A9 | Open Wires | Din Rail
DC 12V Supply | 16 | Relay Module - 2/4 Channel 12V | 12V | DC | Digital Signal | 2 | D0,D1 | Open Wires | N/A
 | 17 | Ultrasonic Water Level Sensor | 12V | DC | 4-20mA | 2 | A10,A11 | Open Wires | Mounting Clips
 | 18 | Proximity Sensor | 12V | DC | Digital Pulses | 2 | D2,D3 | Open Wires | Mounting Bracket and Damping Magnet
 | 19 | 4 Port USB C Hub 10Gbps | 12V | DC | Powered the USB-6453 DAQ | Not Required |  |  | Mounting on Plate
 | 20 | GRAS 12AX 4-Channel CCP Power Module with Gain | 12V | DC | Constant Current Source 2-10mA for GRAS 40PM | 4 | A13,A14,A15,A16 | BNC | N/A
DC 5V Supply | 21 | Horizontal Water Level Sensor | 5V from DAQ | DC | Digital Signal | 4 | D4,D5,D6,D7 | Open Wires | Mounting Clips
 | 22 | Gravity Analog Temperature Sensor - LM35 | 5V from DAQ | DC | 10mV per degree Celsius | 2 | A17,A18 | Open Wires | N/A
Constant Current Source 2-10mA | 23 | GRAS 40PM EQset™ Miniature Production Line Microphone, High Precision | N/A | Constant Current Source 2-10mA | 25 mV/Pa | 4 | Connected to CCP | BNC | Mounting Bracket
 | 24 | CMCP786A Top Exit MS Connector | N/A | Constant Current Source 2-10mA | 100 mV/g | 4 | Connected to HS-551 | Open Wires | Triaxial Mounting Block
Powered from USB-Hub/ PC | 25 | USB-6453 DAQ | 5V USB Type-C Powered | DC | Used for Data Acquistion | Not Required |  |  | Mounting Bracket
N/A | 26 | BNC Breakout Board | N/A | N/A | Open Lead Wires | Not Required |  |  | N/A
Powered from Tachometer | 27 | Incremental Encoder | 12V from Tachometer | DC | Digital Pulses | 2 | D8,D9 | Open Wires | Tachometer
