Huzaifa-Rahim-Malik/Industrial-Fault-Simulator/docs/Sensor_Description.xlsx

S/N | Sensor Name | Signal Type | Total Number | On Rig Setup | In Lab Quantity | Location of Sensors on System | Input Voltage @ Amp | Output Signal Range | Supply Voltage on System | Connector and Cable Requirement | DAQ | Nos. of Pins of Sensor of DAQ Required | Total Nos. of Pins of Sensor of DAQ Required (Total Sensor * No of Pin of DAQ) | Remarks
1 | Accelerometer | Analog | 9 | 3 | 5 | Gear, Induction Motor, Bearing x5, On Table x2 | 18-30VDC @ 0.5mA to 8mA | 100mv/g | 24V DC | M12 Euro fast Connector Cable | USB-4716 | 3 Analog Pins | 15 Analog Pins
2 | Acoustic |  | 7 |  | 0 | Gear, Induction Motor, Bearing x5
3 | Voltage Sensor | Analog | 2 |  | 1 | Induction Motor,Power Supply | 24VDC @4-20mA | 0 to 1000V AC | 24V DC | Not Required Wires can be Screwed. | IDAQ-801 | 1 Analog Pin | 2 Analog Pin
4 | Current Sensor | Analog | 2 | 2 | 3 | Induction Motor,Power Supply | 0 to 30A AC | 0 to 1V AC | - | 2 pin Terminal Block to female RCA Connector Required | IDAQ-801 | 1 Analog Pin | 2 Analog Pin
5 | Temperature sensor | Analog | 4 |  | 5 | Induction Motor,Gear, Small Water Tank and Large Water Tank | 4 to 30V DC @1.5mA | 0 to 5 VDC | 24V DC | 3 pin Male Connector Mating Connector Required | IDAQ-801 | 1 Analog Pin | 4 Analog Pin
6 | Humidity Sensor | Digital | 2 |  | 2 | Small Water Tank and Large Water Tank | 3.3V to 6V DC @ 1 to 1.5mA | 0 to 5V Digital Signal | 5V DC | 4 pin Connector | USB-4716 | 1 Digital Pin | 2Digital Pin
7 | Tachometer | Digital | 2 | 2 | 2 | Before Gear , After Gear | 100-240V AC @ 10VA max | 30V DC @ 100mA | 220V DC | Not Required Wires can be Screwed. | USB-4716 | 1 Digital Pin | 2 Digital Pin
8 | Water Level Sensor (Float Sensor) | Digital | 2 | 2 | 1 | Small Water Tank and Large Water Tank | 220V DC@1.5A | 0 to 5V Digital Signal | - | Not Required Wires can be Screwed. | USB-4716 | 1 Digital Pin | 2 Digital Pin
9 | Flow Sensor | Digital | 2 |  | 2 | Small Water Tank and Large Water Tank | 5V to 15V DC @ 15mA | 0 to 5V Digital Signal | 5V DC | 3 pin Male Connector Mating Connector Required | USB-4716 | 1 Digital Pin | 2 Digital Pin
 |  |  |  | 9
 |  |  |  |  |  | 220V is given through AC supply | 24V is given through UTC3305 | 5V is given through UTC3305 with a Toggle Switch.
