Huzaifa-Rahim-Malik/Industrial-Fault-Simulator/Old_Design/docs/Hardware_Wiring.xlsx

S# | Device | Power Supply | Voltage | Output
1 | AC Induction Motor | AC | 220V (Three Phase) | Nil
2 | Tachometer | 1. AC | 1. 220V (Single Phase) | Digital
 |  | 2. DC | 2. 5V
3 | Incremental Encoder | DC | 12V | Digital
4 | 2-Channel Relay Module | DC | 12V | AC
5 | Electromagnetic Drive Water Pump | AC | 220V (Single Phase) | Nil
6 | 24V DC Adapter | AC | 220V (Single Phase) | 24V DC
7 | Electromagnetic Clutch | DC | 24V | Nil
8 | KTC-812 Controller | AC | 220V (Single Phase) | DC (0-24V)
9 | Powder Brake | DC | 0 to 24V | Nil
10 | ATX Power Supply | AC | 220V (Single Phase) | 5V DC
 |  |  |  | 12V DC
11 | Water Level Sensor | Passive | Nil | Digital
12 | Current Sensor | Passive | Nil | Analog
13 | Accelerometers (MPU9050) | DC | 5V | Analog
14 | Acoustic (LM393) | DC | 5V | Analog
