Huzaifa-Rahim-Malik/Industrial-Fault-Simulator/New_Design/Images/Test_rig.jpeg

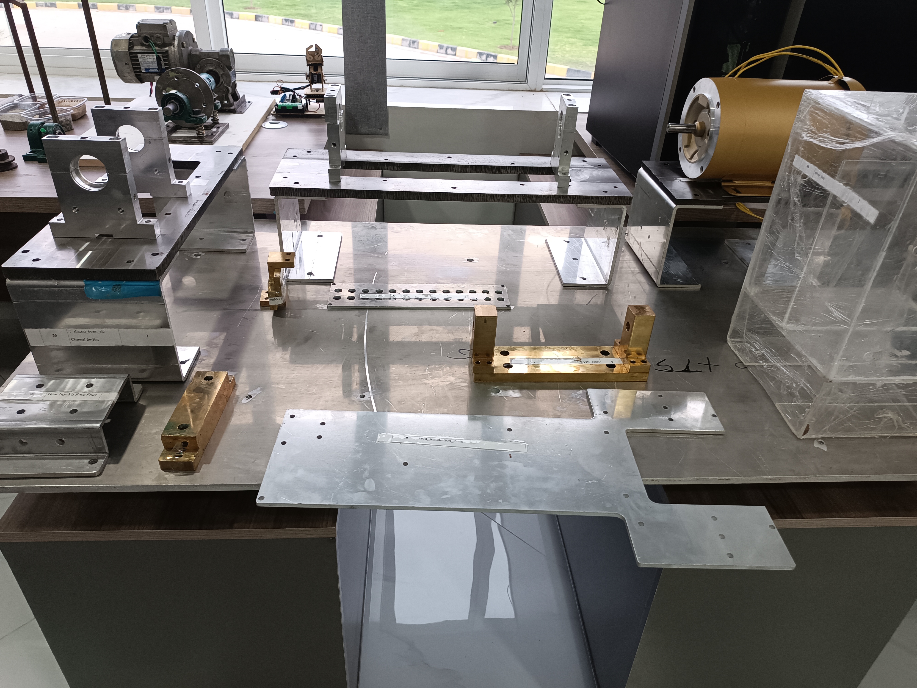
New_Design/Images/Test_rig.jpeg
