Huzaifa-Rahim-Malik/Industrial-Fault-Simulator/images/Fault_Simulator.pdf

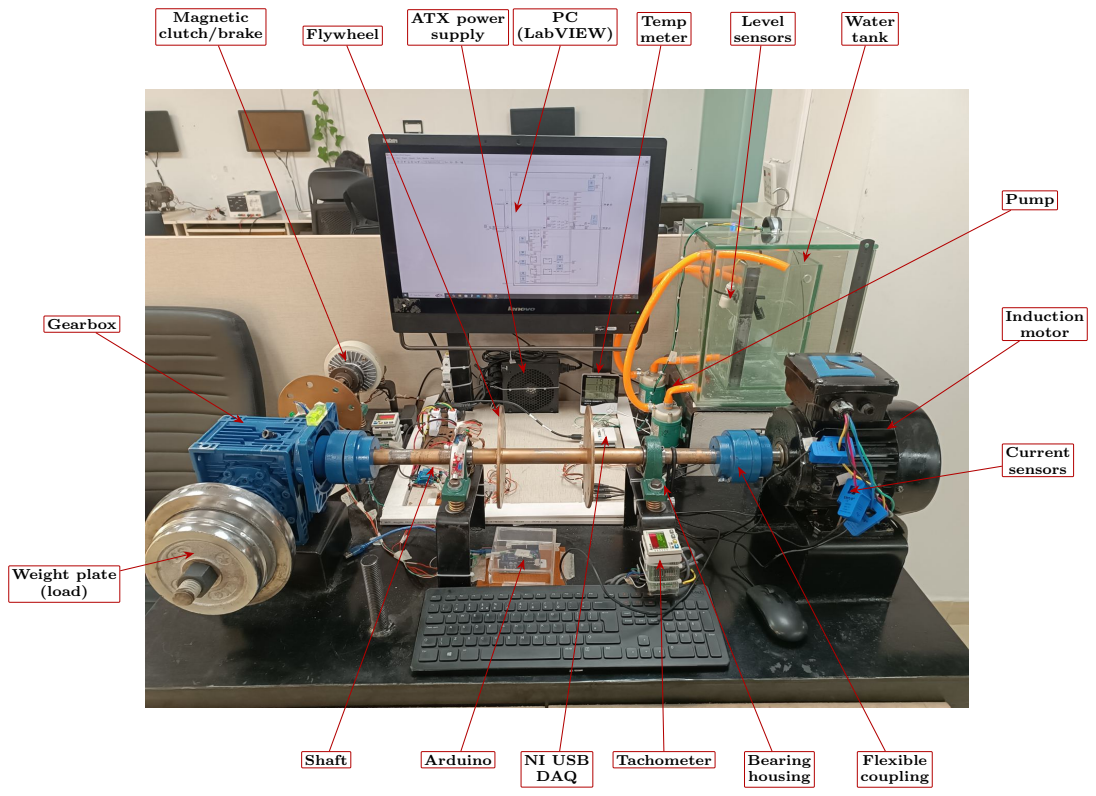
[picture p52: page 1]
Magnetic; clutch/brake; Flywheel; ATX power supply; PC (LabVIEW); Temp meter; Level sensors; Water tank; Pump; Induction motor; Current sensors; Gearbox; Weight plate (load); Shaft; Arduino; NI USB; DAQ; Tachometer; Bearing; housing; Flexible coupling
