Huzaifa-Rahim-Malik/Industrial-Fault-Simulator/docs/Block_Diagram.pdf

# VCC_5V_DC USB-6008 DAQ device Analog Digital

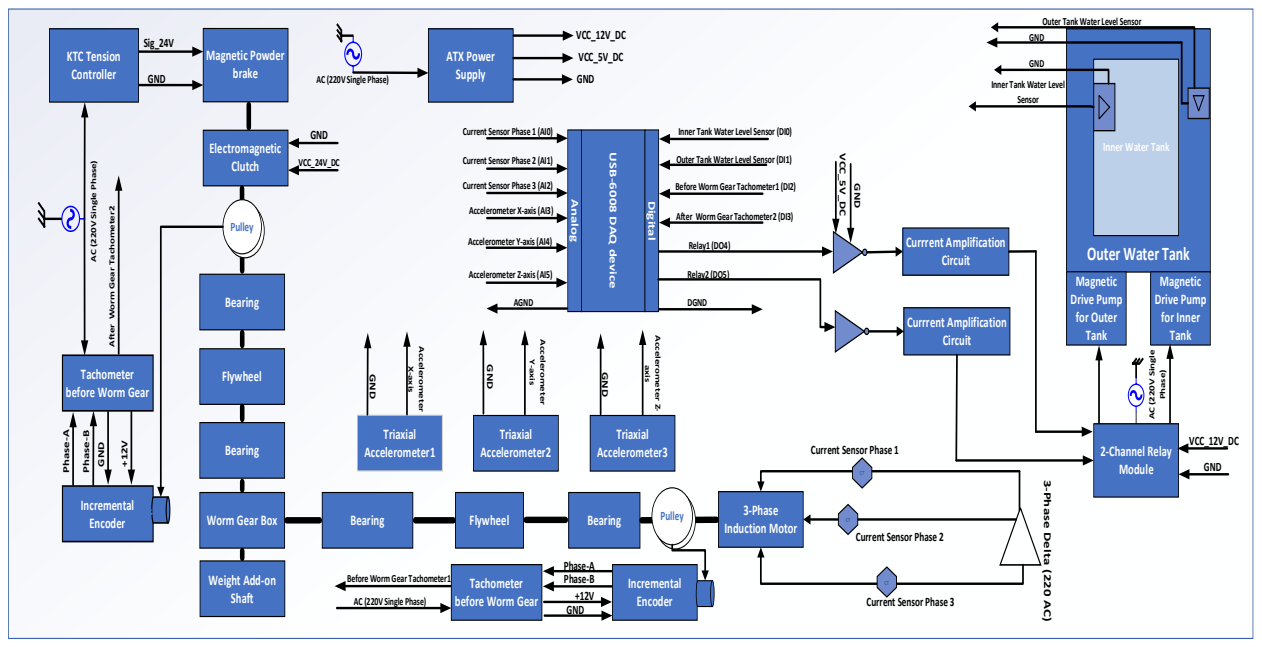
[picture p53: page 1]
Magnetic Powder brake; Electromagnetic Clutch; KTC Tension Controller; Flywheel; Sig_24V; Bearing; 3-Phase Induction Motor; ATX Power; VCC_12V_DC; Relay1 (DO4); Relay2 (DO5); DGND; Accelerometer X-axis (AI3); Accelerometer Y-axis (AI4); Accelerometer Z-axis (AI5); AGND; Incremental Encoder; GND; VCC_24V_DC; Pulley; Pulley Phase⁻A; Phase⁻B; +12V After Worm Gear Tachometer2; Phase-A Phase-B; GND VCC_5V_DC; Currrent Amplification Circuit; 2-Channel Relay Module; Magnetic Drive Pump for Outer Tank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

Outer Tank Water Level Sensor
GND

Supply AC (220V Single Phase)

Inner Tank Water Level
Sensor

Current Sensor Phase 1 (AI0)

Inner Tank Water Level Sensor (DI0)

Inner Water Tank

Current Sensor Phase 2 (AI1)

Outer Tank Water Level Sensor (DI1)

Current Sensor Phase 3 (AI2)

Before Worm Gear Tachometer1 (DI2)

After Worm Gear Tachometer2 (DI3)

Outer Water Tank

Tachometer
before Worm Gear

Current Sensor Phase 1

3-Phase Delta (220 AC)

Worm Gear Box

Current Sensor Phase 2

Weight Add-on
Shaft

Before Worm Gear Tachometer1

Current Sensor Phase 3

AC (220V Single Phase)
