Huzaifa-Rahim-Malik/Industrial-Fault-Simulator/Old_Design/docs/Schematics.pdf

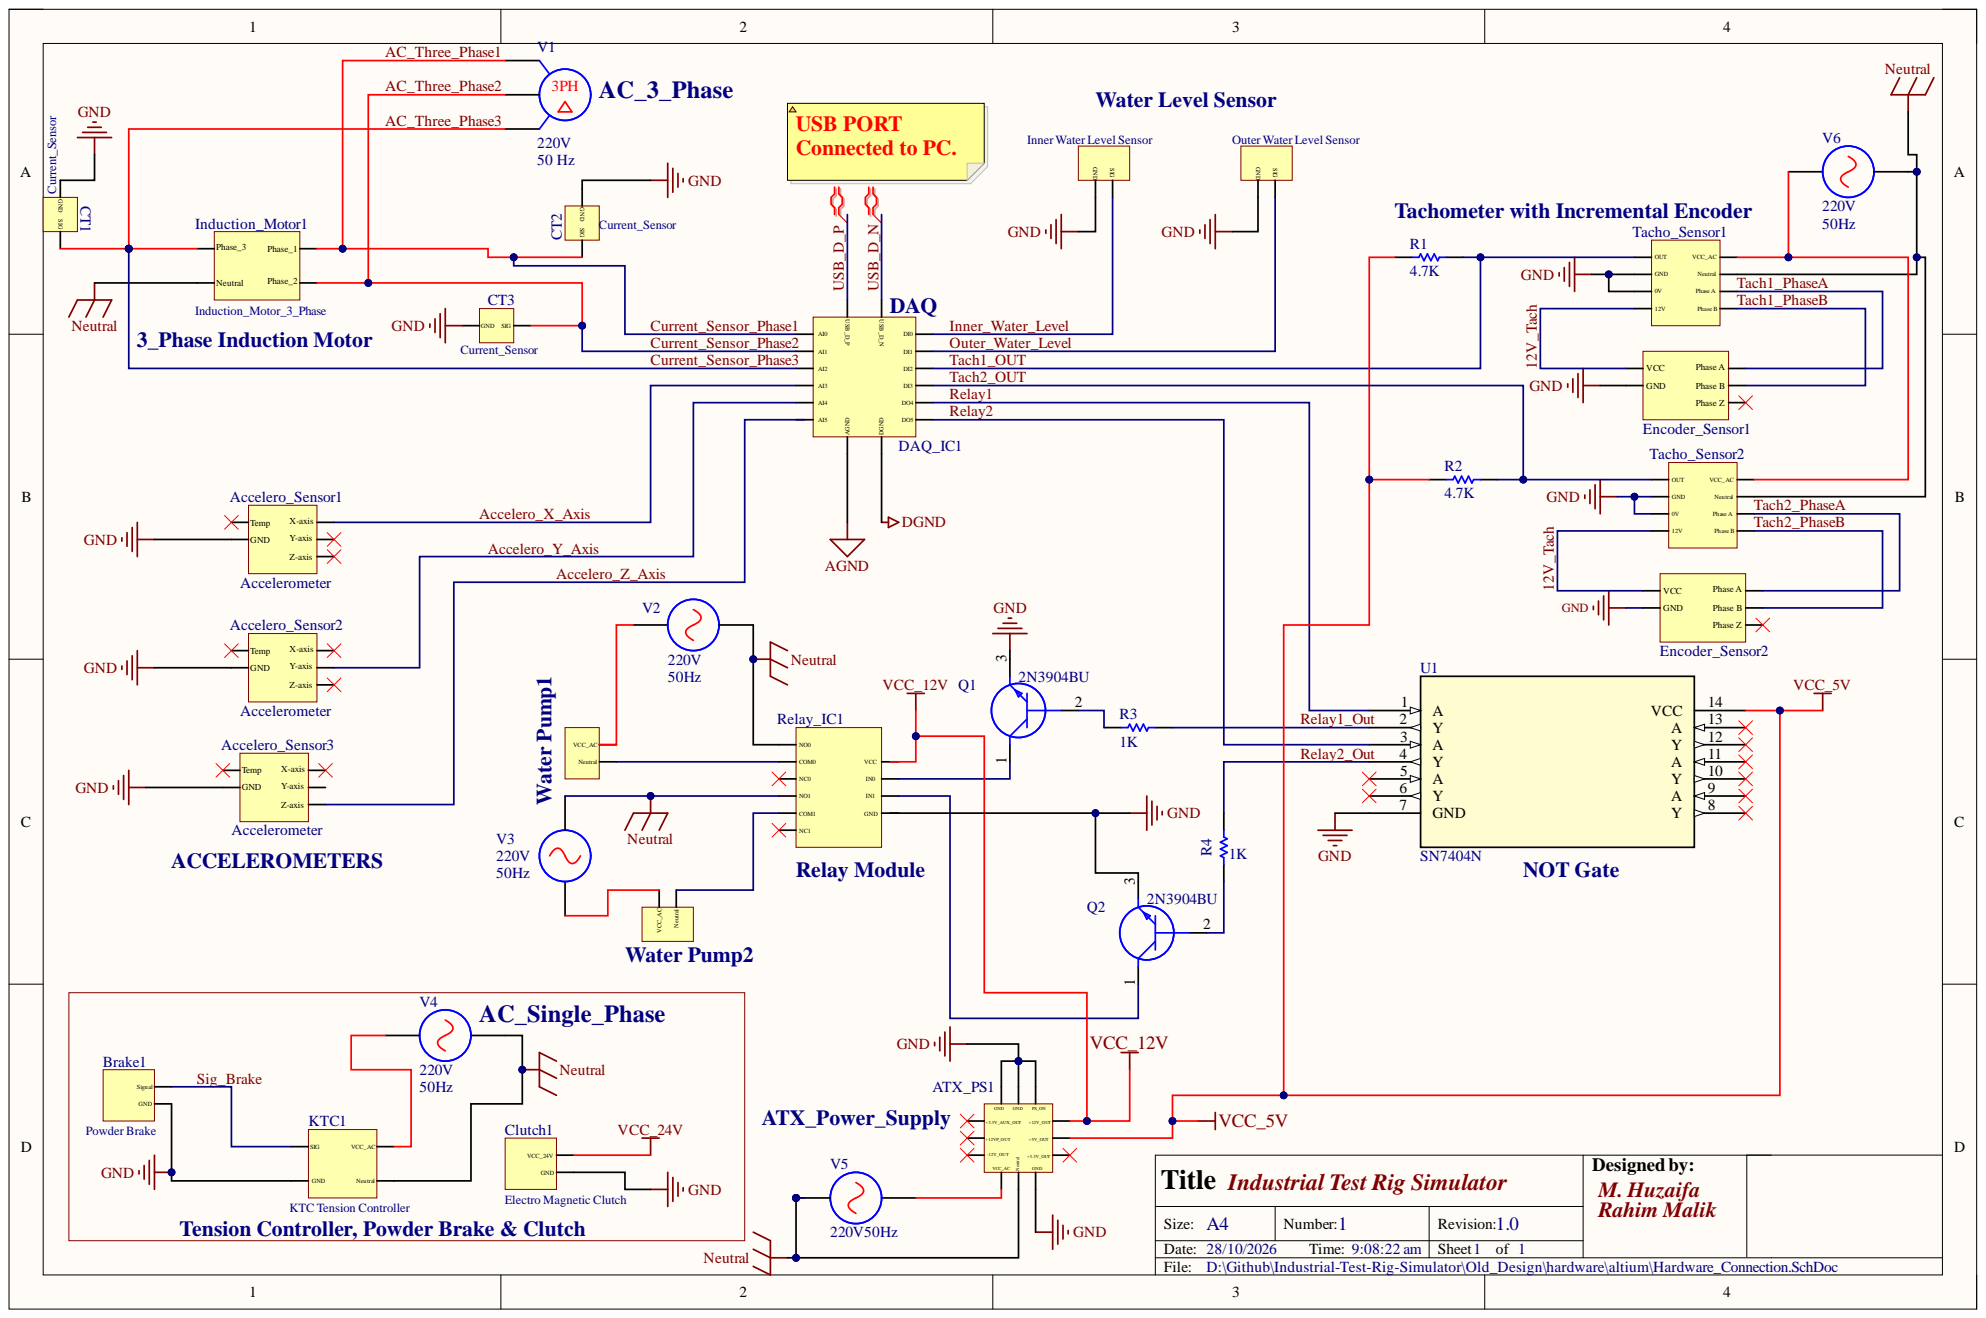
[picture p54: page 1]

Inner Water Level Sensor

Outer Water Level Sensor

Tachometer with Incremental Encoder

Inner_Water_Level | 4.7K

Tach1_PhaseA
Tach1_PhaseB

Current_Sensor_Phase2 | Outer_Water_Level

Tach2_OUT
Relay1 | R2
Relay2

Tach2_PhaseB

Accelero_Y_Axis

Relay2_Out | | Y 4

Industrial Test Rig Simulator

D:\Github\Industrial-Test-Rig-Simulator\Old_Design\hardware\altium\Hardware_Connection.SchDoc

Tension Controller, Powder Brake & Clutch

Comment | Description | Designator | Footprint | LibRef | Quantity
Accelerometer | | Accelero_Sensor1, Accelero_Sensor2, Accelero_Sensor3 | | Accelerometer | 3
ATX_Power_Supply | | ATX_PS1 | | ATX_Supply | 1
Powder Brake | | Brake1 | | Powder Brake | 1
Electro Magnetic Clutch | | Clutch1 | | Electro Magneetic Clutch | 1
Current_Sensor | | CT1, CT2, CT3 | | Current_Sensor | 3
NI USB-6008 | | DAQ_IC1 | | NI USB-6008 | 1
Incremental Encoder | | Encoder_Sensor1, Encoder_Sensor2 | | Incremental Encoder | 2
Induction_Motor_3_P hase | | Induction_Motor1 | | Induction_Motor_3_P hase | 1
Inner Water Level Sensor | | Inner_Water_Level_Se nsor1 | | Water Level Sensor | 1
KTCTension Controller | | KTC1 | | KTCTension Controller | 1
Outer Water Level Sensor | | Outer_Water_Level_Se nsor1 | | Water Level Sensor | 1
2N3904BU | Transistor BJTNPN | Q1, Q2 | LM431ACZ | 2N3904BU | 2
Resistor | Resistor | R1, R2, R3, R4 | | Resistor | 4
Relay | | Relay_IC1 | | Relay | 1
Tachometer | | Tacho_Sensor1, Tacho_Sensor2 | | Tachometer | 2
SN7404N | No Description Available | U1 | N14 | SN7404N | 1
3-PhaseDelta VoltageSource | 3-PhaseDelta VoltageSource | V1 | | 3PhaseDelta | 1
ACVoltageSource | ACVoltageSource | V2, V3, V4, V5, V6 | | ACVoltageSource | 5
Water Pump | | Water_Pump1, Water_Pump2 | | Water Pump | 2
