Huzaifa-Rahim-Malik/Industrial-Fault-Simulator/(list of files, drawings)

Other design files:
hardware/altium/Block_Diagram.SchDoc
hardware/altium/Industrial_Test_Rig_Circuit.PrjPcb
hardware/altium/Schematic.SchDoc
hardware/altium/WD_37,Boot,Power Control.SchDoc
Old Design/hardware/altium/Industrial_Test_Rig_Circuit.PrjPcb
Old_Design/hardware/altium/Hardware_Connection.SchDoc
Old_Design/hardware/altium/Industrial_Test_Rig_Circuit.PrjPcb
